MST-MRDT/MotorController-Gimbal-Powerboard/GimbalMotorController2017.brd

## EAGLE design GimbalMotorController2017.brd (2018-01-29)

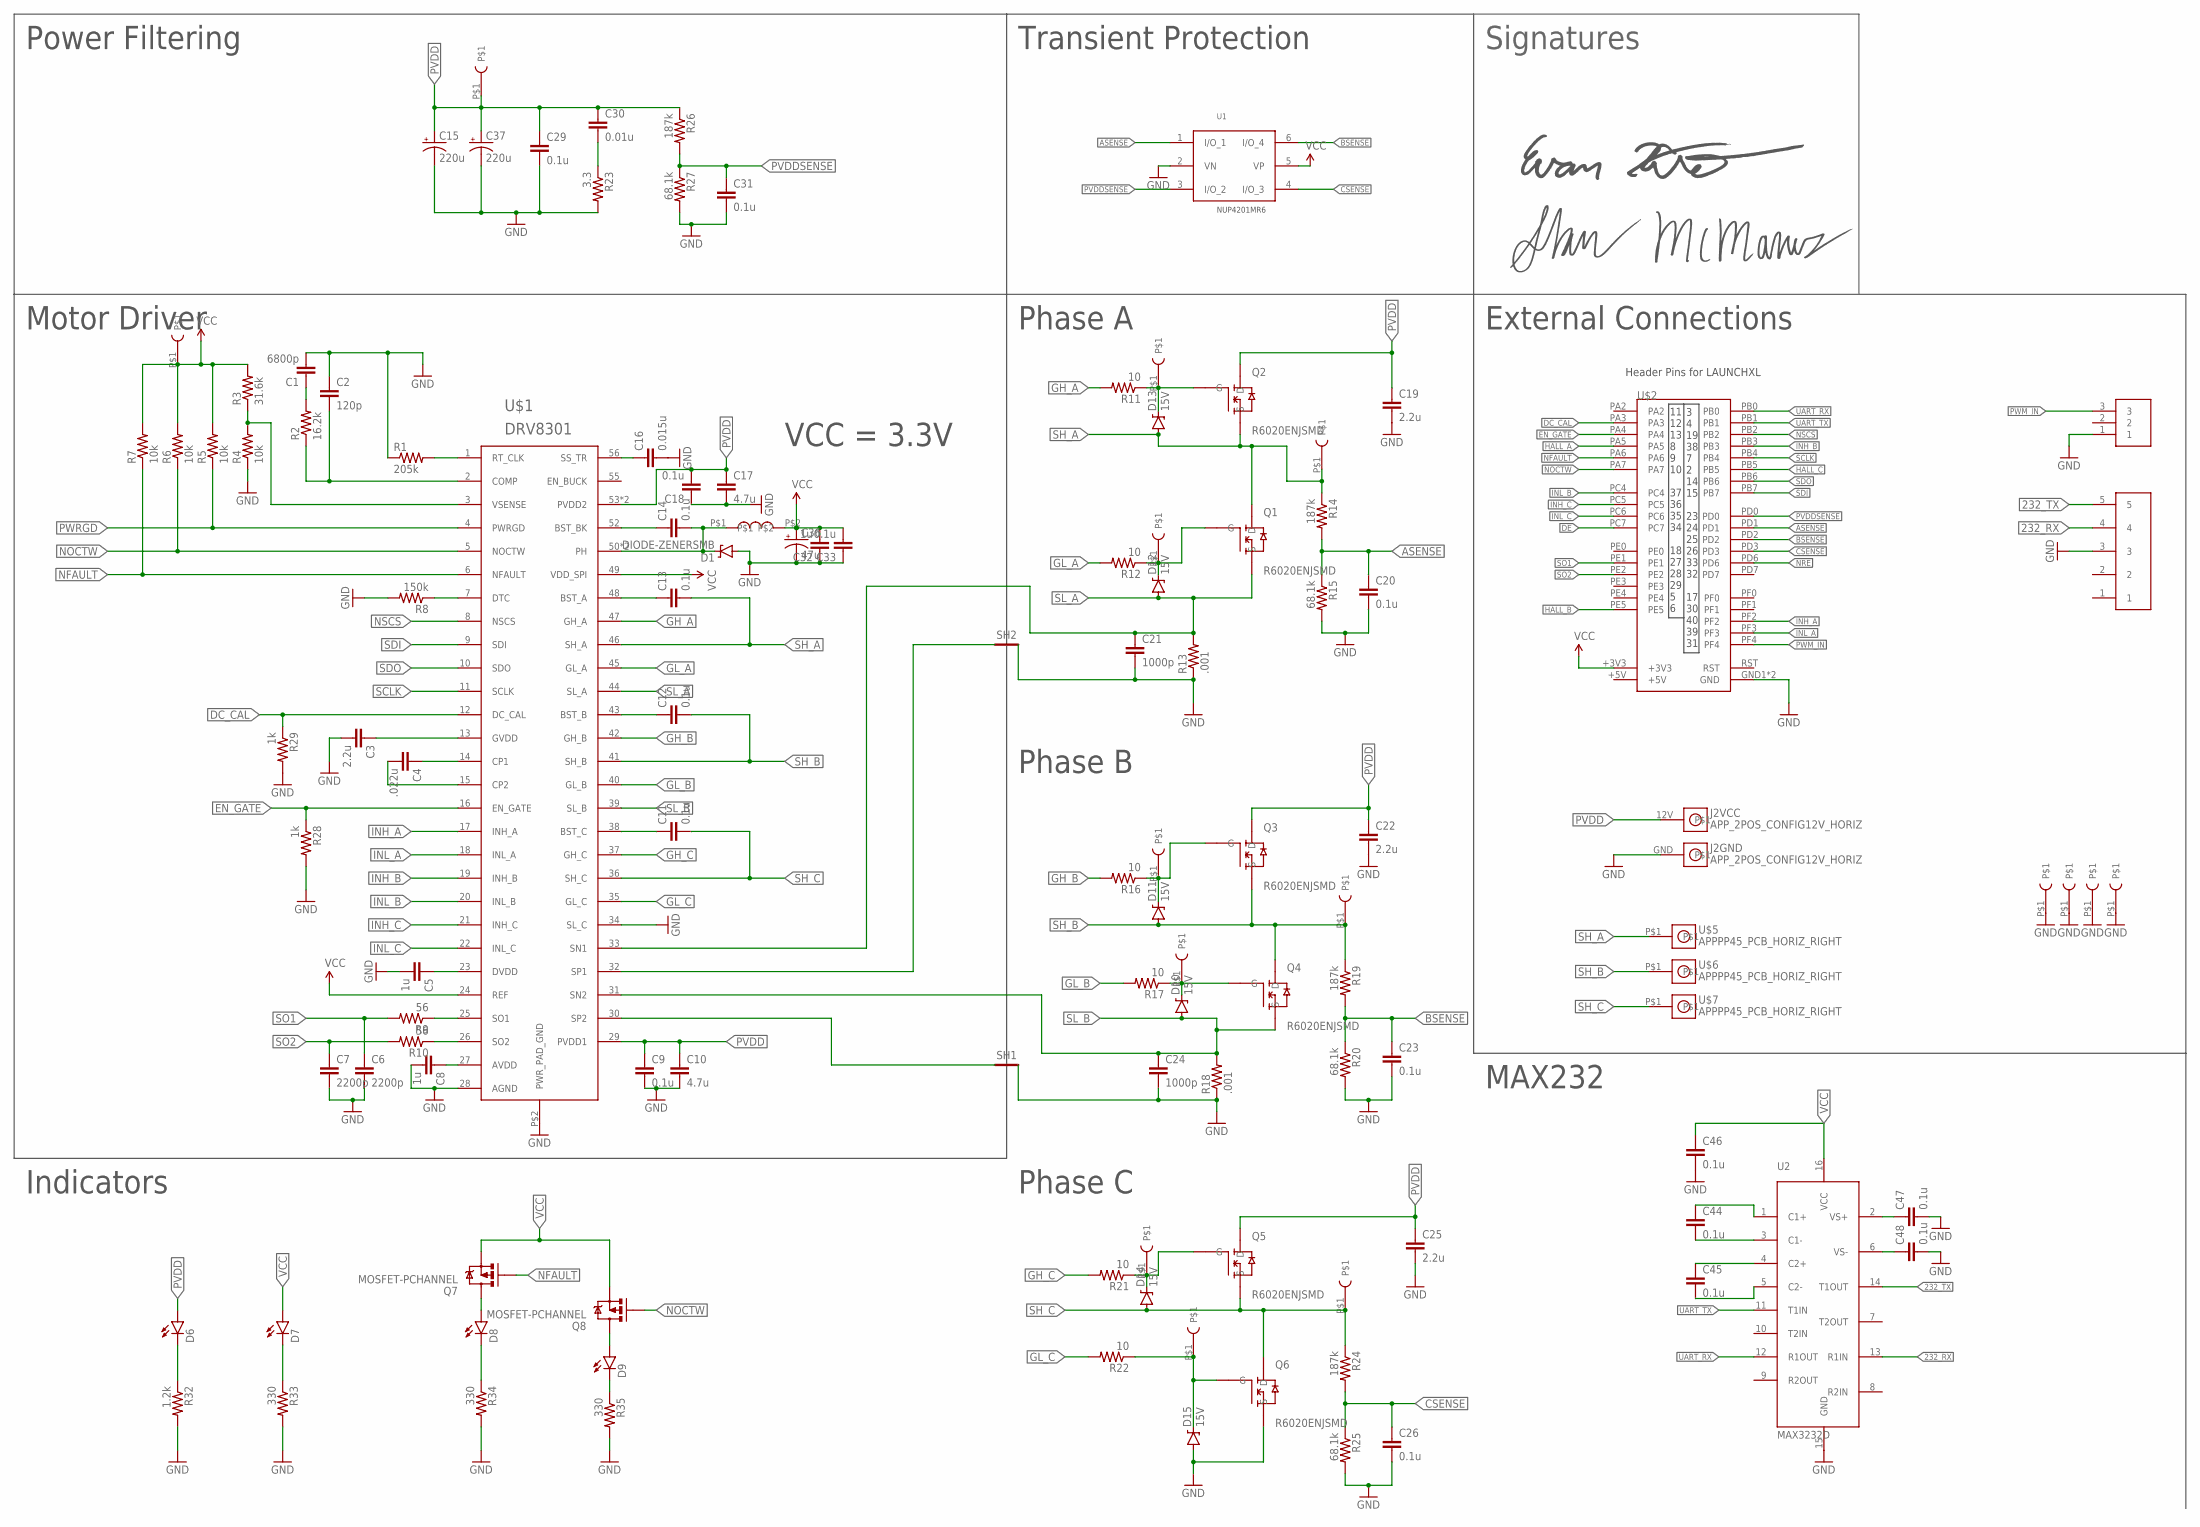
[picture p1: schematic GimbalMotorController2017.sch]

Parts:
C1: 6800p; 0805
C2: 120p; 0805
C3, C19, C22, C25: 2.2u; 1206
C4: .022u; 0805
C5, C8, C32: 1u; 0805
C6, C7: 2200p; 0805
C9, C11, C12, C13, C14, C18, C20, C23, C26, C29, C31, C33, C44, C45, C46, C47, C48: 0.1u; 0805
C10, C17: 4.7u; 1206
C15, C37: 220u; CPOL-RADIAL-1000UF-25V
C16: 0.015u; 0805
C21, C24: 1000p; 0805
C30: 0.01u; 0805
C36: 47u; CPOL-RADIAL-100UF-25V
D1: DIODE-ZENERSMB; SMB-DIODE
D6, D7, D8, D9: LED1206; LED-1206
D10, D11, D12, D13, D14, D15: 15V; SOD-323
J1: SL03THROUGH_HOLE; MOLEX_SL_03_TH
J2: APP_2POS_CONFIG12V_HORIZ; APP45_12V_HORIZ_CONFIG
Q1, Q2, Q3, Q4, Q5, Q6: R6020ENJSMD; D2PACK
Q7, Q8: MOSFET-PCHANNEL; SOT23-3
R1: 205k; 0805
R2: 16.2k; 0805
R3: 31.6k; 0805
R4, R5, R6, R7: 10k; 0805
R8: 150k; 0805
R9, R10: 56; 0805
R11, R12, R16, R17, R21, R22: 10; 0805
R13, R18: .001; 1206
R14, R19, R24, R26: 187k; 0805
R15, R20, R25, R27: 68.1k; 0805
R23: 3.3; 0805
R28, R29: 1k; 0805
R32: 1.2k; 0805
R33, R34, R35: 330; 0805
SH1, SH2: SHORT-HT5; SHORT_TOP-50
U1: NUP4201MR6; TSOP-6
U2: MAX3232D; SOIC16
U$1: DRV8301; TFSOP-56
U$2: TIVA-C
U$3, U$10, U$12, U$15, U$16, U$17, U$18, U$19, U$20, U$24, U$25, U$26, U$27, U$28, U$29: TEST_POINT_0.1INDIAM
U$4: 5PIN
U$5, U$6, U$7: APPPP45_PCB_HORIZ_RIGHT; APP45_PCB_HORIZ_RIGHT
U$8: SHAUN_MCMANUS_SIGNATURE
U$11: EVAN_HITE_SIGNATURE
U$14: 33u; INDUCTOR_DR74

Connections:
232_RX: U2.13 (R1IN), U$4.4
232_TX: U2.14 (T1OUT), U$4.5
+5V: U$2.+5V
ASENSE: C20.1, R14.2, R15.1, U1.1 (I/O_1), U$2.PD1
BSENSE: C23.1, R19.2, R20.1, U1.6 (I/O_4), U$2.PD2
CSENSE: C26.1, R24.2, R25.1, U1.4 (I/O_3), U$2.PD3
DC_CAL: R29.1, U$1.12 (DC_CAL), U$2.PA3
DE: U$2.PC7
EN_GATE: R28.1, U$1.16 (EN_GATE), U$2.PA4
GH_A: R11.2, U$1.47 (GH_A)
GH_B: R16.2, U$1.42 (GH_B)
GH_C: R21.2, U$1.37 (GH_C)
GL_A: R12.2, U$1.45 (GL_A)
GL_B: R17.2, U$1.40 (GL_B)
GL_C: R22.2, U$1.35 (GL_C)
GND: C1.2, C2.1, C3.2, C5.2, C6.2, C7.2, C8.2, C9.2, C10.2, C15.2 (-), C16.2, C17.2, C18.1, C19.2, C20.2, C21.2, C22.2, C23.2, C24.2, C25.2, C26.2, C29.2, C31.2, C32.1, C33.1, C36.2 (-), C37.2 (-), C46.2, C47.2, C48.2, D1.A, D15.A, J1.1, J2.GND, Q6.2 (S), R1.1, R4.1, R8.2, R13.1, R15.2, R18.1, R20.2, R23.2, R25.2, R27.2, R28.2, R29.2, R32.2, R33.2, R34.2, R35.2, SH1.2, SH2.2, U1.2 (VN), U2.15 (GND), U$1.28 (AGND), U$1.34 (SL_C), U$1.P$2 (PWR_PAD_GND), U$2.GND1 (GND), U$2.GND2 (GND), U$4.3, U$26.P$1, U$27.P$1, U$28.P$1, U$29.P$1
HALL_A: U$2.PA5
HALL_B: U$2.PE5
HALL_C: U$2.PB5
INH_A: U$1.17 (INH_A), U$2.PF2
INH_B: U$1.19 (INH_B), U$2.PB3
INH_C: U$1.21 (INH_C), U$2.PC5
INL_A: U$1.18 (INL_A), U$2.PF3
INL_B: U$1.20 (INL_B), U$2.PC4
INL_C: U$1.22 (INL_C), U$2.PC6
unnamed: C2.2, R2.1, U$1.2 (COMP)
unnamed: C1.1, R2.2
unnamed: R3.1, R4.2, U$1.3 (VSENSE)
unnamed: R1.2, U$1.1 (RT_CLK)
unnamed: R8.1, U$1.7 (DTC)
unnamed: C4.1, U$1.14 (CP1)
unnamed: C4.2, U$1.15 (CP2)
unnamed: C3.1, U$1.13 (GVDD)
unnamed: C5.1, U$1.23 (DVDD)
unnamed: R9.1, U$1.25 (SO1)
unnamed: R10.1, U$1.26 (SO2)
unnamed: C8.1, U$1.27 (AVDD)
unnamed: D13.C, Q2.1 (G), R11.1, U$12.P$1
unnamed: D11.C, Q3.1 (G), R16.1, U$16.P$1
unnamed: D10.C, Q4.1 (G), R17.1, U$17.P$1
unnamed: D12.C, Q1.1 (G), R12.1, U$15.P$1
unnamed: D14.C, Q5.1 (G), R21.1, U$18.P$1
unnamed: D15.C, Q6.1 (G), R22.1, U$19.P$1
unnamed: C11.1, U$1.38 (BST_C)
unnamed: C30.2, R23.1
unnamed: D6.C, R32.1
unnamed: D7.C, R33.1
unnamed: C12.1, U$1.43 (BST_B)
unnamed: D8.C, R34.1
unnamed: D9.C, R35.1
unnamed: D9.A, Q8.3 (D)
unnamed: C13.1, U$1.48 (BST_A)
unnamed: C14.1, U$1.52 (BST_BK)
unnamed: C14.2, D1.C, U$1.50 (PH), U$1.51 (PH), U$14.P$1
unnamed: D8.A, Q7.3 (D)
unnamed: C16.1, U$1.56 (SS_TR)
unnamed: C44.1, U2.1 (C1+)
unnamed: C44.2, U2.3 (C1-)
unnamed: C45.1, U2.4 (C2+)
unnamed: C45.2, U2.5 (C2-)
unnamed: C48.1, U2.6 (VS-)
unnamed: C47.1, U2.2 (VS+)
NFAULT: Q7.1 (G), R7.1, U$1.6 (NFAULT), U$2.PA6
NOCTW: Q8.1 (G), R6.1, U$1.5 (NOCTW), U$2.PA7
NRE: U$2.PD6
NSCS: U$1.8 (NSCS), U$2.PB2
PVDD: C9.1, C10.1, C15.1 (+), C17.1, C18.2, C19.1, C22.1, C25.1, C29.1, C30.1, C37.1 (+), D6.A, J2.12V, Q2.TAB (D), Q3.TAB (D), Q5.TAB (D), R26.1, U$1.29 (PVDD1), U$1.53 (PVDD2), U$1.54 (PVDD2), U$3.P$1
PVDDSENSE: C31.1, R26.2, R27.1, U1.3 (I/O_2), U$2.PD0
PWM_IN: J1.3, U$2.PF4
PWRGD: R5.1, U$1.4 (PWRGD)
RST: U$2.RST
SCLK: U$1.11 (SCLK), U$2.PB4
SDI: U$1.9 (SDI), U$2.PB7
SDO: U$1.10 (SDO), U$2.PB6
SH_A: C13.2, D13.A, Q1.TAB (D), Q2.2 (S), R14.1, U$1.46 (SH_A), U$5.P$1, U$25.P$1
SH_B: C12.2, D11.A, Q3.2 (S), Q4.TAB (D), R19.1, U$1.41 (SH_B), U$6.P$1, U$24.P$1
SH_C: C11.2, D14.A, Q5.2 (S), Q6.TAB (D), R24.1, U$1.36 (SH_C), U$7.P$1, U$20.P$1
SL_A: C21.1, D12.A, Q1.2 (S), R13.2, U$1.33 (SN1), U$1.44 (SL_A)
SL_B: C24.1, D10.A, Q4.2 (S), R18.2, U$1.31 (SN2), U$1.39 (SL_B)
SO1: C6.1, R9.2, U$2.PE1
SO2: C7.1, R10.2, U$2.PE2
SP1: SH2.1, U$1.32 (SP1)
SP2: SH1.1, U$1.30 (SP2)
UART_RX: U2.12 (R1OUT), U$2.PB0
UART_TX: U2.11 (T1IN), U$2.PB1
VCC: C32.2, C33.2, C36.1 (+), C46.1, D7.A, Q7.2 (S), Q8.2 (S), R3.2, R5.2, R6.2, R7.2, U1.5 (VP), U2.16 (VCC), U$1.24 (REF), U$1.49 (VDD_SPI), U$2.+3V3, U$10.P$1, U$14.P$2

Notes on the sheet:
11 12 13 8 9 10 37 36 35 34 18 27 28 29 5 6
3 4 19 38 7 2 14 15 23 24 25 26 33 32 17 30 40 39 31
Header Pins for LAUNCHXL
Power Filtering
Motor Driver
Transient Protection
Phase A
Phase B
Phase C
External Connections
Indicators
VCC = 3.3V
MAX232
Signatures

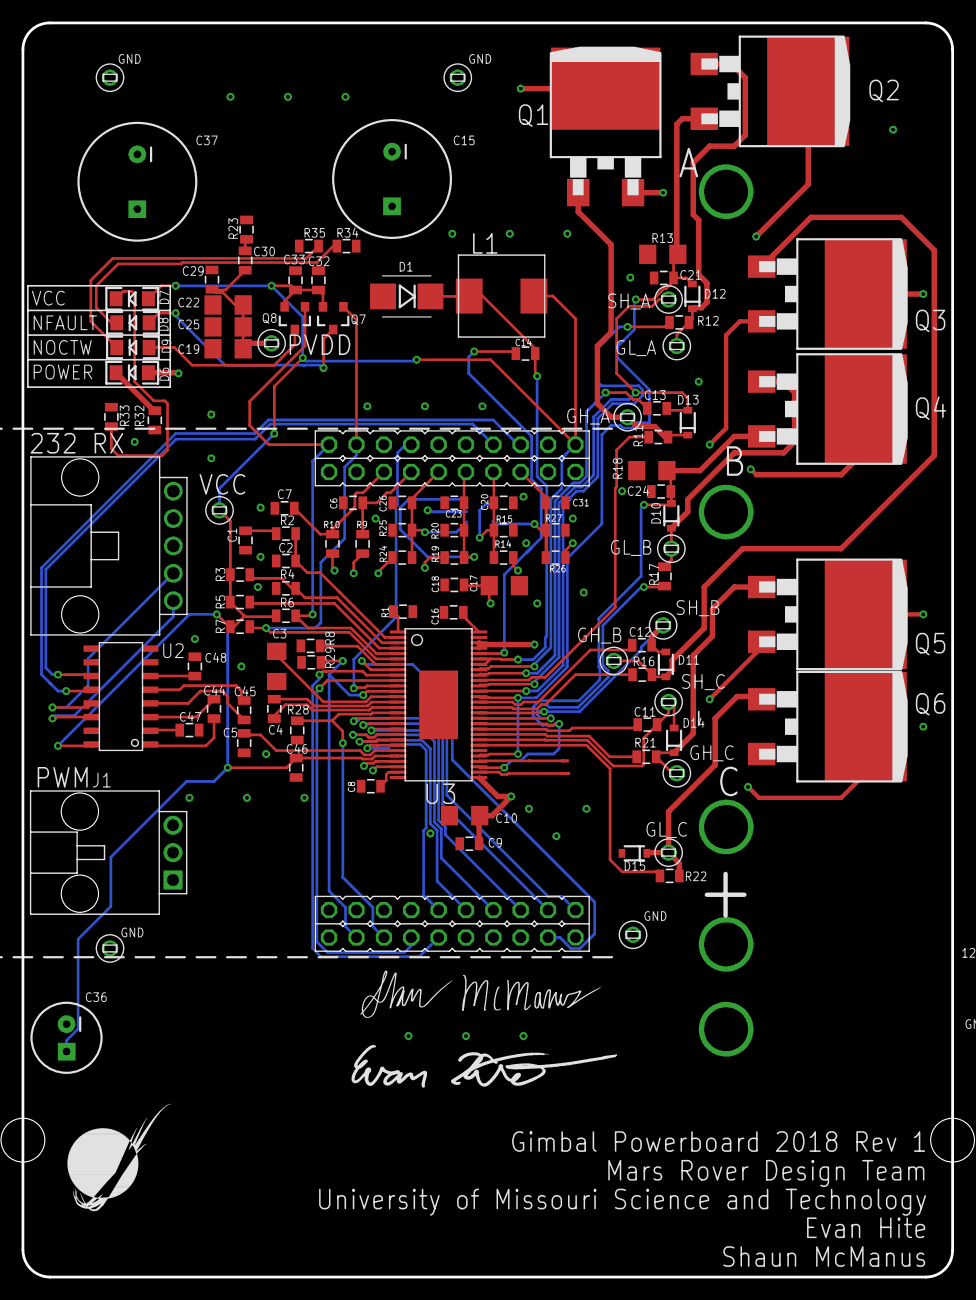
[picture p2: board GimbalMotorController2017.brd from above]

Board: 4 copper layers, 86.2 x 116.3 mm, 121 parts (1 on the bottom side), 79 nets.

Other parts of the board:
U$9: MRDT_LOGO
