MST-MRDT/MotorController-Gimbal-Powerboard/(commit log)

2017-11-05 initial commit with Cameron's reference
    [GimbalMotorController2017.brd, GimbalMotorController2017.sch]
2017-11-08 changed power filtering cap count and R26 value for 12v to 3.3v conversion
    [GimbalMotorController2017.brd, GimbalMotorController2017.sch]
2017-11-10 added CSD18533Q5A fets to Phase C in place of previously used fets
    [GimbalMotorController2017.brd, GimbalMotorController2017.sch]
2017-11-10 added CSD18533Q5A fets to Phase B in place of the previously used fets
    [GimbalMotorController2017.brd, GimbalMotorController2017.sch]
2017-11-10 added CSD18533Q5A fets to Phase A in place of previously used fets. Cleaned up schematic.
    [GimbalMotorController2017.brd, GimbalMotorController2017.sch]
2017-11-10 adjusted phase resistor values for 12v to 3.3v voltage divider
    [GimbalMotorController2017.brd, GimbalMotorController2017.sch]
2017-11-10 removed hall effect sensor connector
    [GimbalMotorController2017.brd, GimbalMotorController2017.sch]
2017-11-10 Shrank size to roughly 11 square inches, moved lots of components and ripped up wires
    [GimbalMotorController2017.brd]
2017-11-10 Add pwm connector to external connections
    [GimbalMotorController2017.brd, GimbalMotorController2017.sch]
2017-11-10 Started routing traces on board
    [GimbalMotorController2017.brd, GimbalMotorController2017.sch]
2017-11-12 Updated silkscreen by removing hall effect sensor indicator and Cameron's signature, mounting holes were squared and board was straightened
    [GimbalMotorController2017.brd]
2017-11-16 Testing a new board layout by moving the fets and andersons to the right of the board. MAX3232 has also been moved to the left closer to its connector
    [GimbalMotorController2017.brd]
2017-11-16 Finished arranging test points, beginning traces
    [GimbalMotorController2017.brd]
2017-11-16 Started Routing
    Connected a lot of components and have started the routing process
    [GimbalMotorController2017.brd, GimbalMotorController2017.sch]
2017-11-26 Finished Tracing
    All clearance issues have been fixed. The board's tracing issues have been fixed. All overlap issues have been fixed. It is now ready for Board Review.
    [GimbalMotorController2017.brd]
2017-11-26 Shrank Board
    Board is now smaller
    [GimbalMotorController2017.brd]
2017-11-30 Smashed and Via Patched the Board
    Almost every surface mount now has a via connecting it to the other three ground plains. Silkscreen is a WIP.
    [GimbalMotorController2017.brd]
2017-11-30 Silk Screen Improvement
    [GimbalMotorController2017.brd]
2017-12-01 Updated silkscreen and moved a cap
    Made some slight clarity changes for better readability
    [GimbalMotorController2017.brd]
2017-12-04 Updated Board
    Now board is updated
    [GimbalMotorController2017.sch]
2017-12-04 Board Updated for Board Review
    [GimbalMotorController2017.brd]
2017-12-18 Fixed certain silkscreen issues and routing
    LED's are now fully labelled and in easy to see places
    [GimbalMotorController2017.brd]
2017-12-18 Forgot to include the schematic for the board
    [GimbalMotorController2017.sch]
2017-12-22 Changed Resistor values for 15v to 3.3v conversion.
    Changed resistor values for 15v to 3.3v conversion. Bumped up the magnitude by 10x per board review #1 suggestions.
    [GimbalMotorController2017.brd]
2017-12-23 Changed Fets Around and redid routing
    Fets are now ABC, instead of CBA. This made for easier routing. Silkscreen is updated and the LED's are properly labelled. FET models are still unchanged. Routing has been cleaned up to the best of my ability. Will try and clean up in future work times.
    [GimbalMotorController2017.brd]
2017-12-23 Reorganized schematic sections
    Added new section for MAX232 and reorganized External connections for clarity
    [GimbalMotorController2017.sch]
2017-12-23 Edited label size for neatness and consistency
    [GimbalMotorController2017.sch]
2017-12-29 Moved Max232 to avoid bridging with SL connectors
    [GimbalMotorController2017.brd]
2018-01-14 Added new FET package, reorganized schematic to further clean up the labeling
    [GimbalMotorController2017.brd, GimbalMotorController2017.sch]
2018-01-15 Updated resistor values to give 3.2v/15v ratio with resistors known to be available on digikey with the 0805 package
    [GimbalMotorController2017.sch]
2018-01-15 Added Vertical Mounting Wing. Integrated New Fets adjusted andersons for Control Card
    0.5 Inches of the Board has been added for a vertical mounting wing. Routing for new fets has been made. Board has been increased in size significantly. Basic Silkscreen adjustments have been made. Board should be ready for Rev 1.
    [GimbalMotorController2017.brd]
2018-01-21 Added Vertical mounting wing
    [GimbalMotorController2017.brd]
2018-01-21 Fixed ERC issue
    [GimbalMotorController2017.brd]
2018-01-22 Updated resistor values for new divider, updated indicators section, changed PWM_IN_NO_FILTER to PWM_IN and removed previous PWM_IN label
    Resistor values updated for 12v to 3.2v ratio. Simplified D6 indicator schematic to be just an LED, resistor, power, and ground. Changed old PWM_IN_NO_FILTER label to PWM_IN in external connections, and removed old PWM_IN label from PA2 pin in external connections.
    [GimbalMotorController2017.brd, GimbalMotorController2017.sch]
2018-01-22 Board routing was cleaned up. Silkscreen was cleaned up. Correct Package for Power Anderson Connectors is now being used.
    Mounting holes were removed. SL connectors were labelled. All test points are correctly named. More vias have been added to stitch the planes together. Traces were redrawn in many places for cleaner paths. Correct Vertical mounting board has been added. Anderson Power Package was changed to correct package. The inductor was moved to reduce noise. The power conditioning capacitor was moved out from under where the control card sits.
    [GimbalMotorController2017.brd, GimbalMotorController2017.sch]
2018-01-22 Silscreen Update
    Added arrows to aid in putting cards together.
    [GimbalMotorController2017.brd]
2018-01-23 Silkscreen Update and Dimension update
    Silkscreen was added for the inductor as well as all the Fets. Dimension of the board was alterred to accomodate a vertical mount with extra headroom to prevent any mechanical complications.
    [GimbalMotorController2017.brd]
2018-01-24 Another Silkscreen update
    LED's silkscreen was added for better visibility.
    [GimbalMotorController2017.brd]
2018-01-25 Added a bill of materials
    [GimbalMotorController2017 BOM.xlsx]
2018-01-25 Fixed LED positions
    [GimbalMotorController2017.brd]
2018-01-28 Vertical Mounting drill hole size increased
    [GimbalMotorController2017.brd]
2018-01-29 Added Signatures and BOM file is now text file
    [GimbalMotorController2017 BOM.csv, GimbalMotorController2017 BOM.xlsx, GimbalMotorController2017.brd, GimbalMotorController2017.sch]
2018-03-11 Removed outdated BOM
    [GimbalMotorController2017 BOM.csv]
